raintyaa/smartplug-iot/docs/diagrams/ranova-system-architecture.html

Dark

Style

Visual identitySto cycle

ClassicStable technical default Signal FlowMotion-forward presentation BlueprintEngineering review EditorialPublication and launch notes

Live Present

Export

Export diagramPortable, clean outputs

E

Share Route Share Card1200×630 PNG Reach Share Card1200×630 PNG Copy diagramPNG to clipboard

Image PNGLossless image JPEGCompact image WebPModern image

Vector & motion SVG · AutoMatches host theme SVG · LightAlways light SVG · DarkAlways dark WebM6s motion

# Arsitektur Sistem RANOVA Smart Plug IoT

Integrasi Edge ESP32, Mayar QRIS Payment Gateway, Firebase RTDB & Dashboard

Diagram guide Explore this system ×

Inspecting compiled semantics

01 Find any nodeSearch labels, responsibilities, kinds, and stable IDs. / 02 Trace a routeAsk how two semantic nodes connect in authored direction. R 03 See the whole systemOpen Semantic Radar with a live viewport and stable nodes. M 04 Compare semantic kindsCount roles, reveal their traffic, and compare direct authored links. L 05 Enter Presentation StageGive the live diagram the viewport without changing export. F

E ExportT ThemeS Style0 Reset+ Zoom in- Zoom outEsc Close

Find a node ×

⌕ /

No matching nodes

Semantic passport

Verified source

Authored reach

Upstream0 Downstream0

× Copy link Relations

Path Click where the path starts Find start Copy link Clear

Click two nodes on the diagram

← ▶ Journey → Overview

Click a start, then an end. Paths follow the arrows.

Semantic lens Compare system roles ×

Choose up to two semantic kinds. One reveals its real traffic; two compare only direct authored relationships.

Choose a kind to inspect its nodes and touching relationships.

Copy link Clear

Semantic radar Building overview Open radar ×

Click nodeDrag to pan

Semantic radar needs more MAP space.

Notes & index

PATH MAP LENS 100%

### Alur Pembayaran QRIS Dinamis

- Pengguna scan QRIS Mayar di box dan membayar nominal sewa
- Mayar memicu callback HTTP POST Webhook ke Vercel Serverless
- Vercel menghitung durasi dan mengupdate Firebase RTDB menjadi ACTIVE

### Keselamatan & Kontrol Fisik

- Sensor DHT22 memicu Emergency Cutoff seketika jika suhu box >= 50°C
- Tombol metal debounced memproses pembatalan atau early stop
- Relay 4-channel active-LOW mengisolasi tegangan AC 220V secara aman

### Monitoring & Rekonsiliasi

- PZEM-004T mengukur tegangan, arus beban, daya nyata, dan energi kWh
- ESP32 melakukan streaming telemetri secara berkala ke Firebase RTDB
- Web Dashboard Laravel menyinkronkan rekaman transaksi ke MySQL lokal
