raintyaa/smartplug-iot/RANOVA QRIS.png

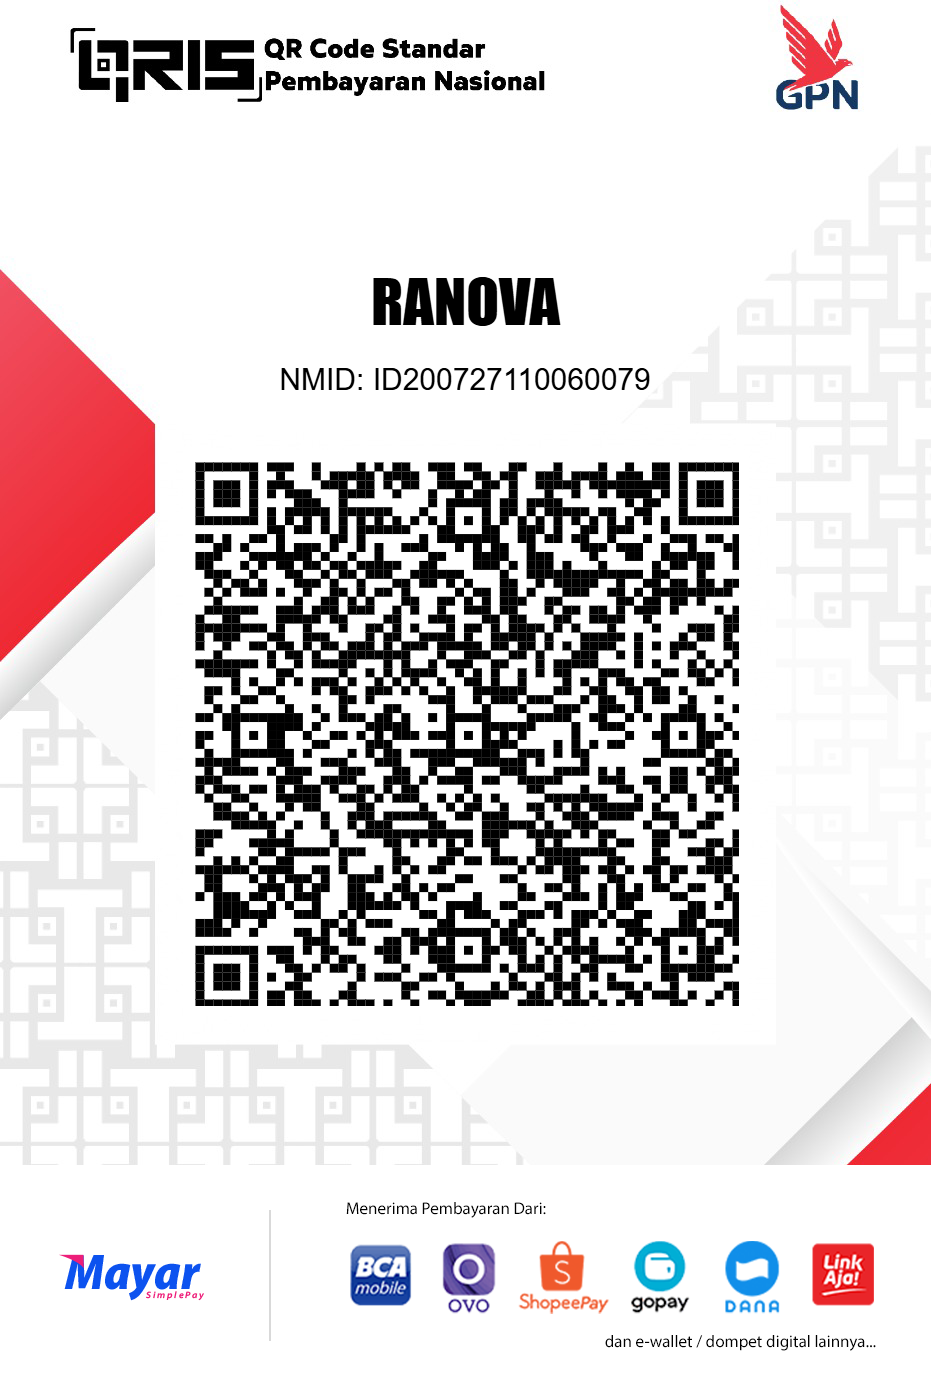
RANOVA QRIS.png
