raintyaa/smartplug-iot/(commit log)

2026-08-27 docs: update spesifikasi - tambah sensor DHT22, fitur auto-shutdown, dan opsi casing 3D print/ABS
    Pembaruan hasil konsultasi asisten dosen (27 Agustus 2026):
    - Sensor kedua: DHT22 untuk proteksi suhu internal casing
    - 3 skenario relay OFF: timer habis, idle (PZEM), overheat (DHT22)
    - Casing: beralih dari triplek ke Box Panel ABS atau 3D Print (ABS/PETG)
    - Judul proyek: Sistem Smart Plug Berbasis ESP32 Terintegrasi QRIS Payment Gateway dan Monitoring Daya Listrik
    - Pin budgeting updated: 14 pin dari 25+ GPIO (DHT22 di GPIO 4)
    - Analisis biaya & keuntungan dari data sensor PZEM-004T
2026-08-28 feat: add landing page and interactive web dashboard for RANOVA
2026-08-28 refactor: separate external CSS/JS and adjust landing page to reflect academic prototype status
2026-08-31 docs: update hardware BOM, vertical enclosure design, AC wiring specs, and mounting guidelines
2026-09-07 docs: clarify physical-to-digital user flow (button press before QR scan) and update casing to plywood
2026-09-09 fix: handle none slot value, update Firebase JSON without nulls
2026-09-14 feat: add ESP32 firmware for Wokwi simulation (sketch + diagram + libs)
2026-09-14 feat: v1.1 - add PZEM-004T power sensor, integrated LED ring, 4-ch relay
2026-09-14 docs: update README with pin-to-pin wiring guide, refined LCD UX flow, and phase 2 progress
2026-09-19 test: add Tes 1A - LCD I2C standalone test sketch with I2C scanner
2026-09-19 test: add Tes 1B - Metal push button 16mm and LED ring test sketch
2026-09-19 test: add Tes 1C - Relay channel 1 + button 1 + LED ring integration test
2026-09-19 docs: update Roadmap and progress with successful physical hardware tests (1B Button & 1C Relay)
2026-09-19 docs: add complete hardware wiring guide with WAGO power distribution, daisy-chaining, and AC 220V architecture
2026-09-19 feat: add Tahap 2 test sketch - end-to-end single slot cloud & QRIS payment test
2026-09-19 fix: add startup 3x blink test to verify LED ring wiring on boot
    [test_2_payment_gateway.ino]
2026-09-19 fix: resolve instant timeout bug caused by unsigned integer underflow on waitStartMs
    [test_2_payment_gateway.ino]
2026-09-19 fix: resolve instant reset on ACTIVE state caused by now - activeStartMs underflow
    [test_2_payment_gateway.ino]
2026-09-19 docs: mark Tahap 2 End-to-End Single-Slot Cloud & Payment Gateway as 100% SUCCESS
2026-09-19 docs: add steker Dutron assembly, single socket AC test steps, parallel topology theory, and optocoupler safety
2026-09-20 docs: mark Tahap 3 physical AC 220V load test as 100% SUCCESS and update wiring guide
2026-09-21 docs: update wiring guide with 5V power supply configuration, 8-9 WAGO slot mapping, and CT separation
2026-09-21 refactor: remove DHT22 temperature and humidity from main realtime dashboard tab
2026-09-21 fix: restore DHT22 temperature and humidity cards to dashboard with clean 0 default state
2026-09-21 feat: add test_1d_dht22 sketch for temperature and humidity sensor verification
2026-09-21 fix: resolve button debounce bug and enable fast SSL in test_3 sketch
    [test_3_single_slot_with_pzem.ino]
2026-09-21 fix: resolve unsigned long underflow on waitStartMs timeout check
    [test_3_single_slot_with_pzem.ino]
2026-09-21 fix: synchronize dual-node Firebase paths, extend payment timeout to 180s, and add wait timer refresh
    [test_3_single_slot_with_pzem.ino]
2026-09-21 fix: eliminate timestamp mismatch timeout and add resilient slot fallback
2026-09-21 feat: add clear PZEM diagnostic error log on NaN telemetry response
    [test_3_single_slot_with_pzem.ino]
2026-09-21 fix: explicitly initialize Serial2 on GPIO 16/17 at 9600 baud for PZEM
    [test_3_single_slot_with_pzem.ino]
2026-09-22 docs: record finalized component procurement and 3-slot wiring decisions
2026-09-22 feat: ESP32 offline detection + NTP timestamp fix + Firebase cleanup
    - dashboard.blade.php: tambah logika heartbeat/watchdog JS
    - Deteksi ESP32 offline jika updated_at tidak berubah >10 detik
    - Badge merah 'ESP32 Offline/Terputus' muncul otomatis saat offline
    - Semua sensor (Suhu, Kelembaban, Tegangan, Arus, Daya, kWh) di-nol-kan
    - Badge hijau 'ESP32 Online' saat koneksi normal kembali
    - firmware test_3.ino: perbaiki updated_at dari millis() ke Unix timestamp
    - Tambah #include <time.h>
    - configTime(7*3600, ...) NTP sync di connectWiFi() setelah WiFi connect
    - updated_at sekarang pakai time(nullptr) = detik sejak epoch (akurat)
    - Firebase RTDB: hapus 15 transaksi uji coba Mayar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
    [test_3_single_slot_with_pzem.ino]
2026-09-23 feat(dashboard): apply industrial matte dark UI and fix slot route binding
2026-09-23 chore: add PowerShell utility script to reset Firebase RTDB
2026-09-26 style(transactions): resolve nested card anti-pattern by unbundling filter toolbar
2026-09-26 style(sensors): resolve impeccable anti-patterns and align to matte dark system
2026-09-27 feat(firmware): add final 3-slot production sketch and sync dashboard titles
    - Add smartplug_3slot.ino production firmware supporting 3 relays, PZEM-004T, DHT22, and dual-node Firebase sync
    - Remove legacy Wokwi simulation folders
    - Standardize dashboard page titles and navigation labels
    - Add Wiring Project documentation
2026-10-05 fix(system): resolve dashboard telemetry display, transaction sync, and button latency
    - Include updated_at in dashboard realtime sensor payload so ESP32 online badge and metrics render accurately
    - Implement automatic sync from Firebase RTDB /transactions to MySQL transactions table
    - Persist incoming PZEM & DHT22 telemetry into MySQL power_readings and temperature_readings
    - Optimize ESP32 firmware with atomic single-request fbPatch, 0ms instant hardware feedback on button presses, and 2000ms HTTP timeout
    [smartplug_3slot.ino]
2026-10-11 fix: dual-node slot polling and isolated standby reset to activate relay after payment
2026-10-11 fix(firmware): add hardware button interrupts and single-request batch polling for instant early stop
2026-10-11 docs: align system logic, troubleshooting guide, wiring guide, and readme with latest firmware progress
2026-10-11 docs(readme): remove fallback web portal, align qris flow, and strip emojis for academic presentation
2026-10-11 docs(wiring): strip emojis and polish formatting for academic presentation
2026-10-14 feat(dashboard): make sync clock and ESP32 heartbeat global across all tabs and enable live sensor telemetry
2026-10-14 feat(firmware): integrate WiFiManager captive portal with non-blocking reconnect and button reset
2026-10-14 fix(firmware): remove hardware interrupts on buttons and implement 50ms software debounce to eliminate AC 220V EMI false triggers
2026-10-14 fix(dashboard): synchronize overheat temperature threshold to 50C across database, dashboard views, firmware tests, and documentation
2026-10-15 refactor(dashboard,landing): resolve impeccable critique with accessible modals, anti-dom-thrashing, mobile topbar, and landing alignment
2026-10-15 fix(views,a11y): resolve sensors Collection TypeError, flat topbar chips, and remove AI anti-patterns
2026-10-15 refactor(views,perf,a11y): add polling backoff, honest sensor fallbacks, modal focus trap, and shared head
2026-10-15 fix(sensors): zero-out temperature, humidity, and electrical readings when ESP32 is offline
2026-10-17 feat(mqtt,freertos): migrate to Full-MQTT architecture with FreeRTOS dual-core UI task and anti-ghost slot offline handling
2026-10-17 fix(dashboard,firmware,webhook): resolve status flapping, restore button sync, and add hybrid telemetry sync
2026-10-17 feat: add background ajax with toast notification and button mutual exclusion for qris
